vinhtran99/Digital-Systems-Design/README.md

# Digital-Systems-Design Course

Simulation on LTSpice
Schematic and PCB Design on Pad Layout and Logic.

A digital system using LM35 thermometer sensor. Data transmitted over distance with ADC.
The project consists of four different circuits, which are: analog signal processing, transmitter, receiver and ADC.
