vinhtran99/Digital-Systems-Design/(list of files, drawings)

Other design files:
receiver-final.pcb
Transmitter.pcb
