vinhtran99/Digital-Systems-Design/(commit log)

2019-12-04 add Transmitter Schematic and PCB
    [Transmitter.pcb, Transmitter.sch]
2021-01-09 add receiver schematics and pcb
    [receiver-final.pcb, receiver-final.sch]
